Plomyk1/Comet-Dryer/README.md

# Comet Dryer


Comet Dryer hero image

Comet Dryer is a 3D printer filament dryer, with support for drying 2 spools at once!

I made this project, because I felt like trying to make something more complicated than all my previous projects. Decided on a filament dryer, since it was something I wanted to have, and the dryers i could buy seemed quite expensive for essentially just heating air inside a box

## Features:
- 50w Heater
- Fan for even distrubution of hot air
- A colorful 320x170 display
- Rotary encoder for navigating the menus
- UI fully written in C++ with the Adafruit GFX Library
- 13 Color themes
- 15 presets for drying different materials and dessicant

## CAD Model: 
Full cad assembly
Enclosure
Heater and fan bracket

The PCB and enclosure is put together with 5 M3x10 screws and heatset insters. Both the barrel jack and power switch is press fit into the enclosure. The heater and fan addembly is mounted with 2 M5x80 screws. The fan is screwed the the 3D printed bracket with 4 M4x20 screws

You can find all the STL and STEP files in the [CAD directory](/CAD)

## PCB:
Back side of the PCB
Front side of the PCB

The PCB has been designed to be manufactured by PCBWay. It may also fit the requirements of other manufacturers, but that is currently untested!
You can view the PCB wiring on KiCanvas with the button at the top of the readme

PCB power wiring diagram

Diagram showing how the PCB is connected to power to the power supply

### If you want to make this dryer yourself, have a look at the assembly instructions in the [assembly.md](assembly.md) file!

## Credits:
Libraries I used: 
- [Adafruit ST7789](https://github.com/adafruit/Adafruit-ST7735-Library) by Adafruit Industries
- [Adafruit GFX](https://github.com/adafruit/Adafruit-GFX-Library) by Adafruit Industries
- [Adafruit AHTX0](https://github.com/adafruit/Adafruit_AHTX0) by Adafruit Industries
- [RotaryEncoder](https://github.com/mathertel/RotaryEncoder) by Matthias Hertel

AI use:

I have only used AI for debugging, and minor got help with electrical issues. All code in firmware.cpp was written by me
