Plomyk1/Comet-Dryer/CAD/README.md

You can find the full assemblies in the STEPs folder. The STLs folder only includes things ment to be 3D printed

If you want to see how I made everything, you can view my CAD [here](https://cad.onshape.com/documents/a778b5edc86127cb74244df1/w/2368e3ce15f5868e0e34b6d9/e/8c6bc288f30ad08ca65c21fe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)
