Plomyk1/Comet-Dryer/BOM.csv

Item name | Qty | Total price (USD) | Link | Notes
12v 10.5A PSU | 1 | 18,84 | https://allegro.pl/produkt/zasilacz-modulowy-mean-well-12v-12-5a-150w-lrs-150-12-4e65e1d5-06b7-4d24-8f40-de88eebae00e?offerId=15477527985 | I recommend getting this over a brick (barrel jack) power supply. Model: Mean Well LRS-150-12
PCB | 1 | 14,20 | PCBWay | Price quoted from PCBWay, since that is where I had my PCB manufactured. Includes Fees, shipping and taxes
Container | 1 | "7 | 35" | https://www.ikea.com/pl/pl/p/ikea-365-pojemnik-na-zywnosc-z-pokrywka-prostokat-plastik-s79276760/
50mm Fan | 1 | 2,54 | https://pl.aliexpress.com/item/1005006020005975.html
AHT20 + BMP280 module | 1 | 2,18 | https://pl.aliexpress.com/item/1005008239843130.html | Themperature and humidity sensor. The BMP280 isn't used
12v 50w PTC Heater | 1 | 5,77 | https://pl.aliexpress.com/item/1005009279284775.html
Female barrel jacks | 1/10 | 2,32 | https://pl.aliexpress.com/item/1005012242149457.html | Only one of the 10 is used
1.9" TF 320x170 Display | 1 | 5,24 | https://pl.aliexpress.com/item/1005010094030749.html
KY040 Rotary encoder | 1 | 2,54 | https://pl.aliexpress.com/item/1005008796691020.html
IRLZ44N Mosfets | 2/10 | 3,36 | https://pl.aliexpress.com/item/1005009630861300.html | 2 of the 10 are used
KCD101-1 Power switch | 1/5 | 1,95 | https://pl.aliexpress.com/item/1005013414323454.html | 1/5 is used. Different listing from my order
RP2040-Zero | 1 | 4,99 | https://www.waveshare.com/rp2040-zero.htm?sku=20335
Step-down buck converter | 1 | 0,89 | https://pl.aliexpress.com/item/1005012741976007.html | LM2596S. 1,19USD shipping
1N4007 Diode | 1/10 | 1,39 | https://pl.aliexpress.com/item/1005012179615414.html | 1/10 is used
Heatset inserts | 5/50 | 2,54 | https://pl.aliexpress.com/item/1005006472702418.html | 5/10 are used. M3xL4xOD4.5 50Pcs option
M3x10 screws | 5/30 | 1,57 | https://www.leroymerlin.pl/produkty/sruba-walcowa-z-rowkiem-30-mm-stal-ocynk-3-x-10-mm-30-szt-standers-82582805.html | Local vendor. 5/30 screws screws in the package are used
M4x20 screws | 2/20 | 1,49 | https://www.leroymerlin.pl/produkty/sruba-plaska-srednica-20-mm-stozkowa-stal-ocynk-4-x-20-mm-20-szt-standers-82582740.html | Local vendor. 5/30 screws screws in the package are used
M5x80 screws | 2/6 | 1,57 | https://www.leroymerlin.pl/produkty/sruba-plaska-srednica-6-mm-stozkowa-stal-ocynk-5-x-80-mm-6-szt-standers-82582794.html | Local vendor. 2/6 screws screws in the package are used
~1.5mm² Wire (16AWG) | ~0.5m | 1,00 | https://www.leroymerlin.pl/produkty/przewod-elektryczny-ydyp-2-x-1-5-450-750v-aks-zielonka-41302926.html | I used some wires I already had. The lenght and price is estimated
Sunlu PETG HS | 39.17g | 0,49 | 3D printed | Does not include previous designs / failed attempts
Professional LAB ASA | 21.14g | 0,21 | 3D printed | Does not include previous designs / failed attempts
