Plomyk1/Comet-Dryer/CAD/STEPs/Fan and heater mounting assembly.step

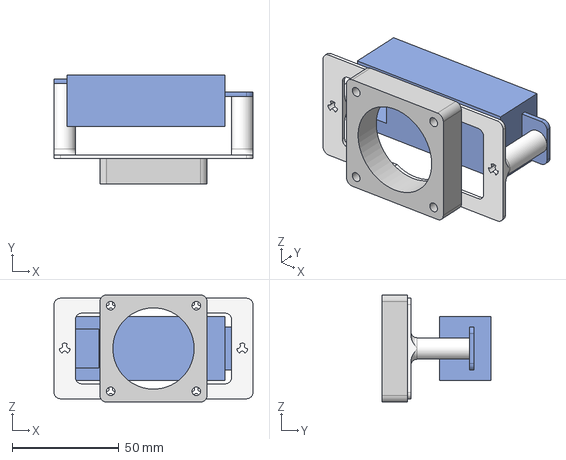
[picture p1: CAD file, 2026-10-28]
CAD/STEPs/Fan and heater mounting assembly.step
93.0 x 51.0 x 50.0 mm
