Plomyk1/Comet-Dryer/CAD/STEPs/FULL assembly.step

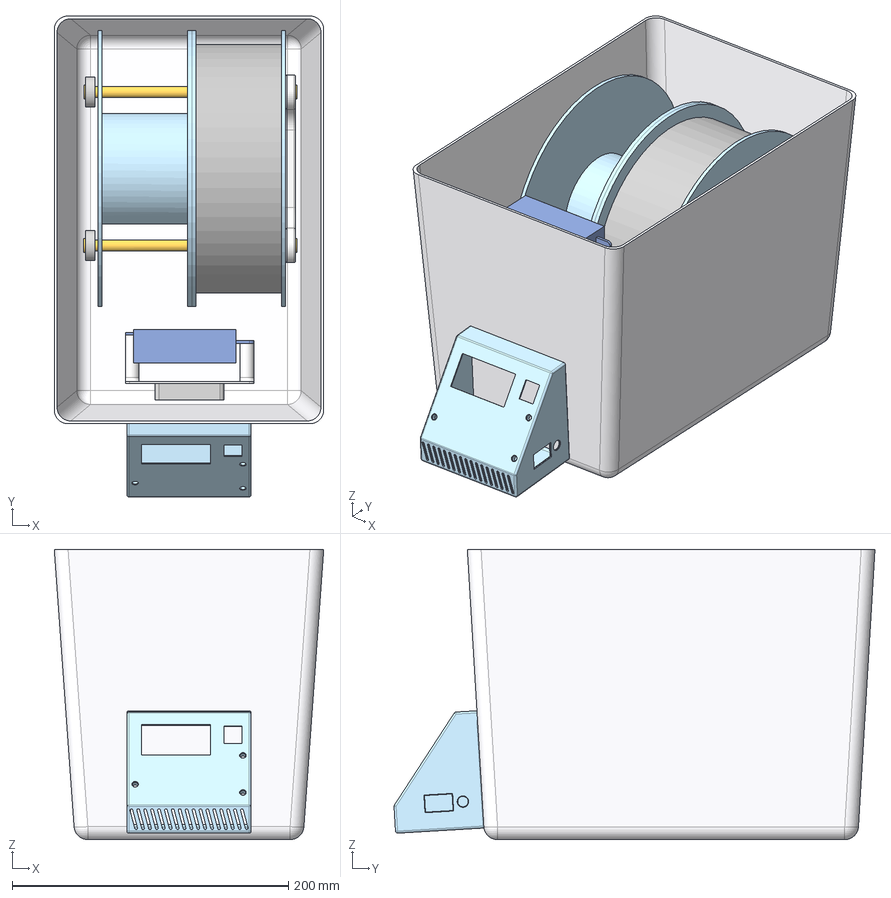
[picture p2: CAD file, 2026-10-28]
CAD/STEPs/FULL assembly.step
195.0 x 348.0 x 210.0 mm
Bearing x 4
Rod x 2
Spool x 2
End cap x 4
Container
Enclosure
Filament
Stand
Fan
Heater
Mounting bracket
