Plomyk1/Comet-Dryer/CAD/STEPs/Spool stand assembly.step

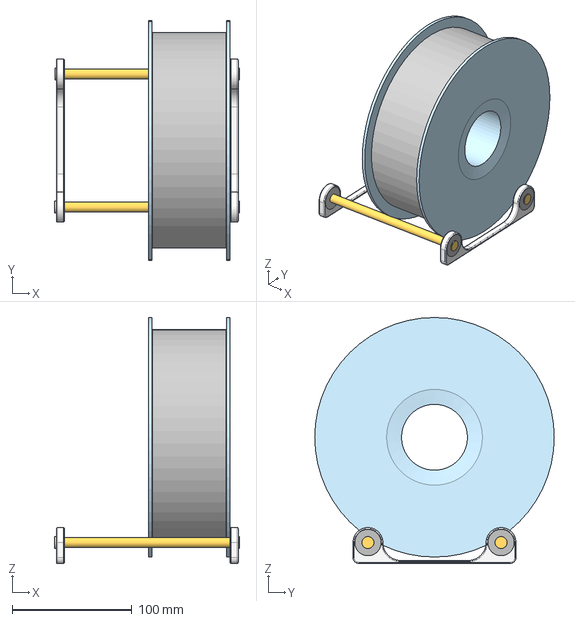
[picture p3: CAD file, 2026-10-28]
CAD/STEPs/Spool stand assembly.step
154.5 x 200.0 x 205.4 mm
