Plomyk1/Comet-Dryer/CAD/STEPs/Fan and heater mounting bracket.step

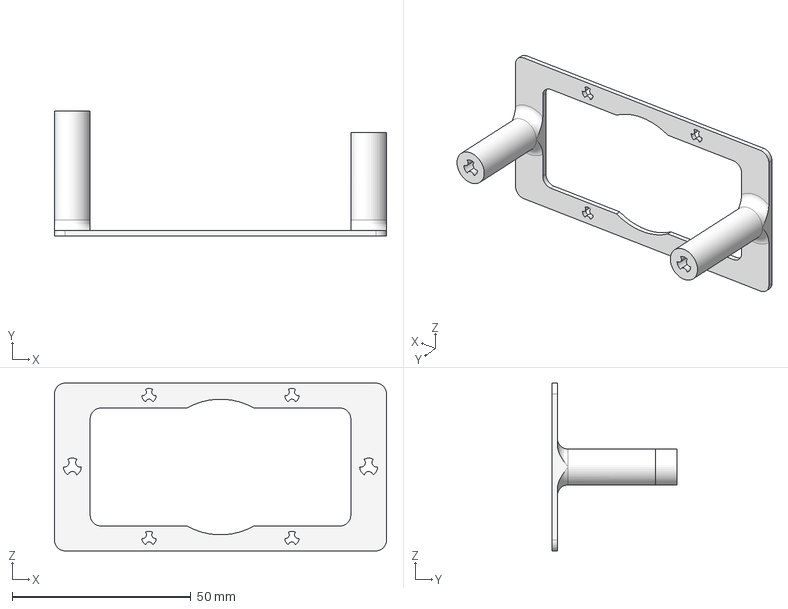
[picture p4: CAD file, 2026-10-28]
CAD/STEPs/Fan and heater mounting bracket.step
93.0 x 35.0 x 47.0 mm
