Plomyk1/Comet-Dryer/CAD/STLs/Heater and fan mounting bracket.stl

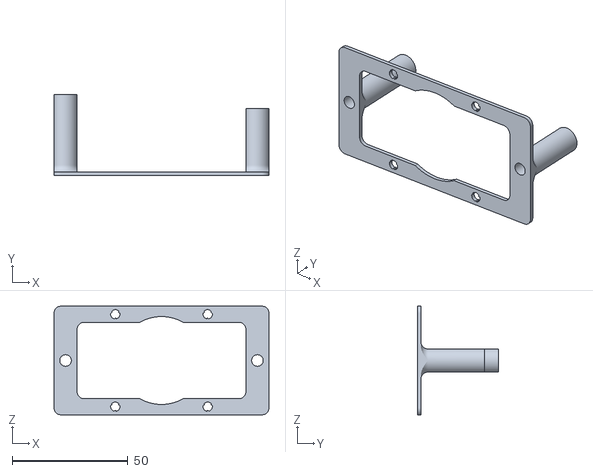
[picture p5: CAD file, 2026-10-28]
CAD/STLs/Heater and fan mounting bracket.stl
93.0 x 35.0 x 47.0
