Plomyk1/Comet-Dryer/CAD/STEPs/Spool stand.step

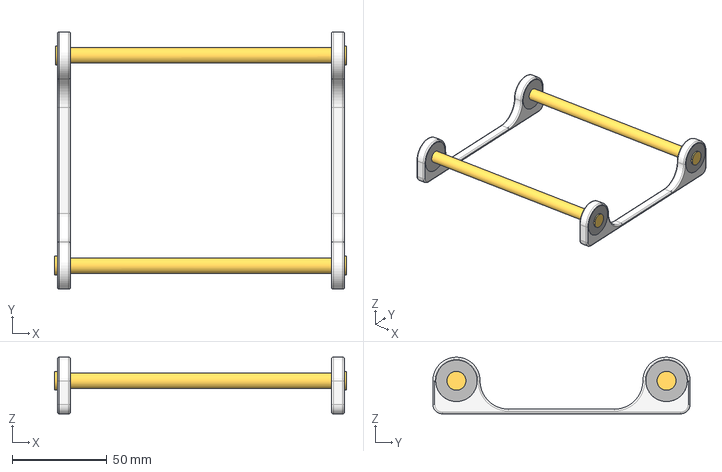
[picture p6: CAD file, 2026-10-28]
CAD/STEPs/Spool stand.step
154.5 x 136.2 x 30.0 mm
