Plomyk1/Comet-Dryer/CAD/STEPs/Enclosure v2.step

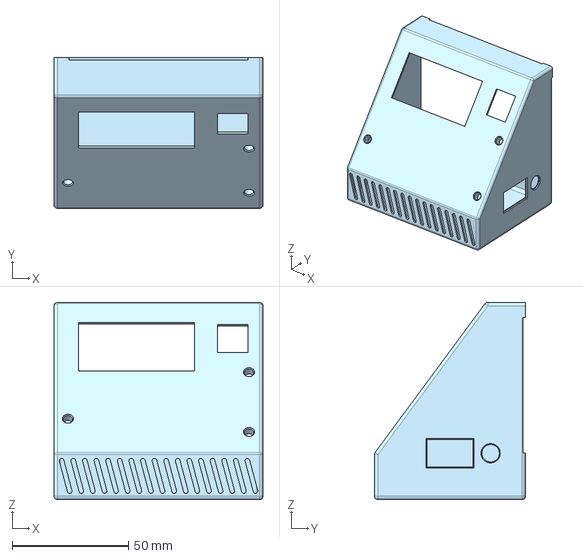
[picture p7: CAD file, 2026-10-28]
CAD/STEPs/Enclosure v2.step
90.0 x 65.0 x 85.0 mm
