Plomyk1/Comet-Dryer/(list of files, cad)

Other CAD files:
CAD/STLs/Enclosure v2.stl
CAD/STLs/Spool stand.stl
