Plomyk1/Comet-Dryer/PCB/Filament Dryer.kicad_pcb

## KiCad design PCB/Filament Dryer.kicad_pcb (2026-10-28)

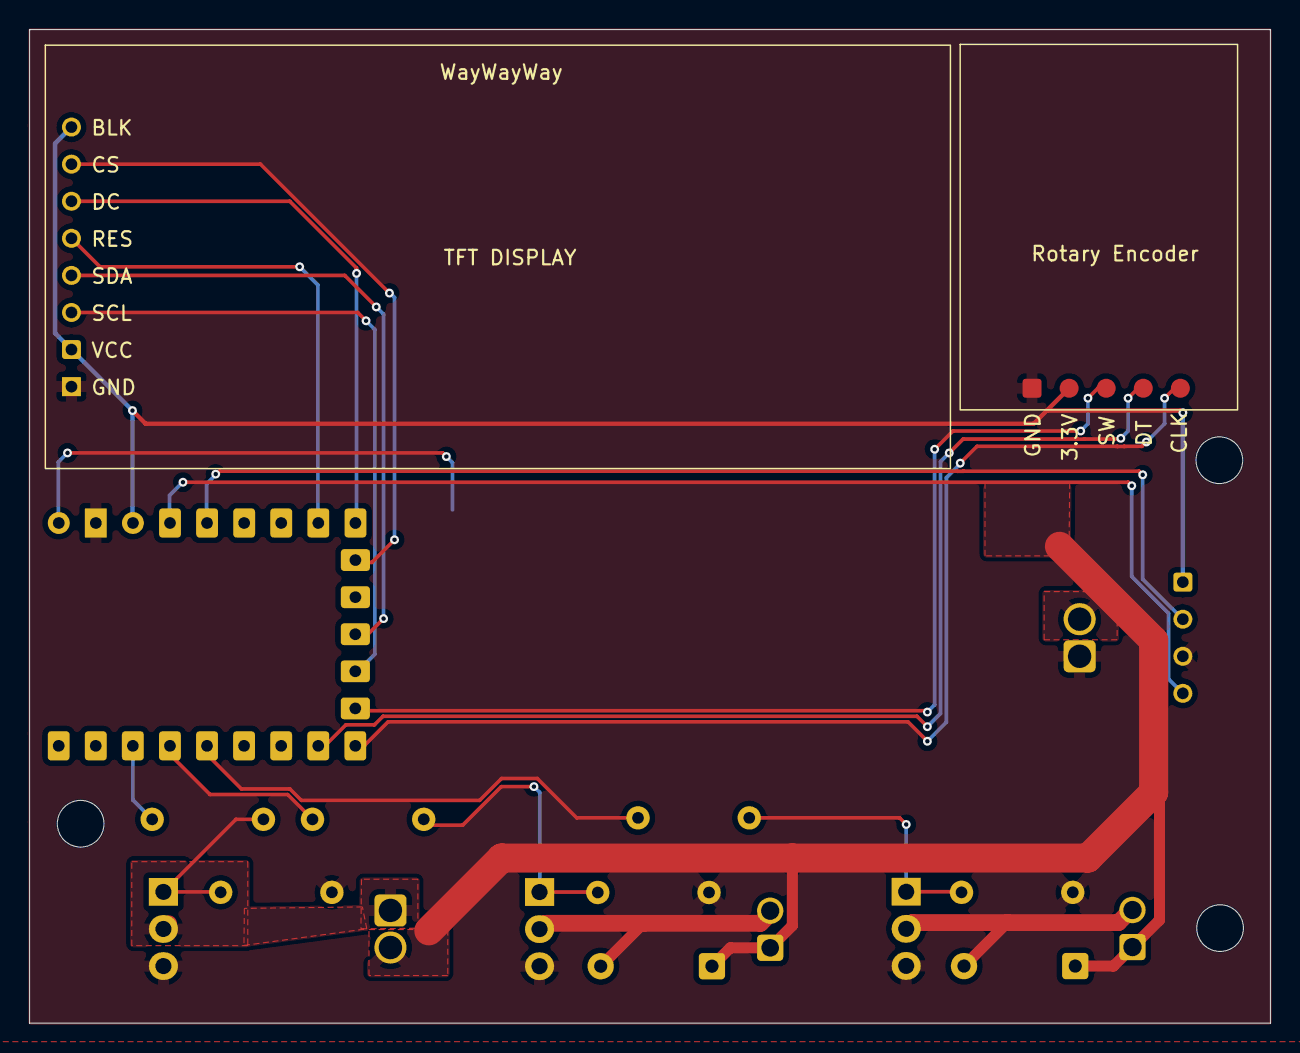
[picture p8: board Filament Dryer.kicad_pcb from above]

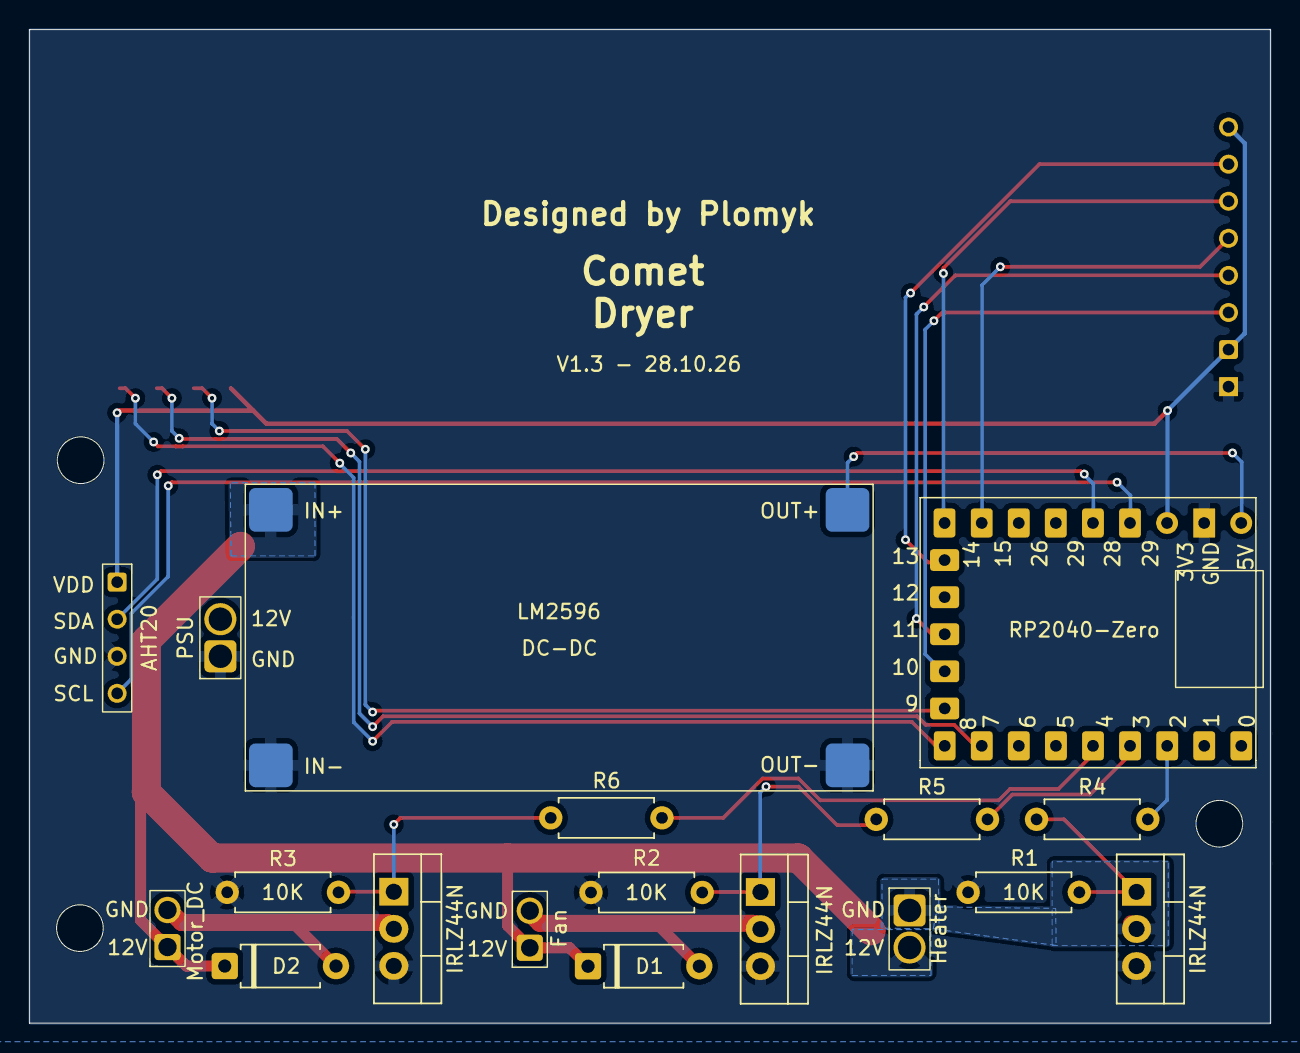
[picture p9: board Filament Dryer.kicad_pcb from below]

Board: 2 copper layers, 85.0 x 68.1 mm, 20 parts (17 on the bottom side), 23 nets.

Parts:
D1, D2: D; D_A-405_P7.62mm_Horizontal
M1: Fan; Fan footprint
M2: Motor_DC; Motor footprint
Q1, Q2, Q3: IRLZ44N; TO-220-3_Vertical
R1, R2, R3: 10K; R_Axial_DIN0207_L6.3mm_D2.5mm_P7.62mm_Horizontal
R4, R5, R6: 220; R_Axial_DIN0207_L6.3mm_D2.5mm_P7.62mm_Horizontal
U1: LM2596; LM2596 module footprint
U2: RP2040-Zero; RP2040-Zero Devboard footprint
U3: KY040; KY-040 Rotary encoder footprint
U4: 320x170 TFT; 1.9' TFT Display footprint
U5: Heater; Heater footprint
U6: PSU; PSU +12V footprint
U8: AHT20; Temperature sensor footprint

Connections:
+3.3V: U2.30 (3.3V), U3.2 (VCC), U4.2 (VCC), U4.8 (BLK), U8.1 (VDD)
+5V: U1.3 (OUT+), U2.32 (5V)
+12V: D1.1 (K), D2.1 (K), M1.1 (+), M2.1 (+), U1.1 (IN+), U5.2 (+12V), U6.2 (12V)
GND: Q1.3 (S), Q2.3 (S), Q3.3 (S), R1.2, R2.2, R3.2, U1.2 (IN-), U1.4 (OUT-), U2.31 (GND), U3.1 (GND), U4.1 (GND), U6.1 (GND), U8.3 (GND)
unnamed: D1.2 (A), M1.2 (-), Q2.2 (D)
unnamed: D2.2 (A), M2.2 (-), Q3.2 (D)
unnamed: Q1.2 (D), U5.1 (GND)
unnamed: Q1.1 (G), R1.1, R4.2
unnamed: Q2.1 (G), R2.1, R5.2
unnamed: Q3.1 (G), R3.1, R6.2
unnamed: R4.1, U2.2 (GPIO)
unnamed: R5.1, U2.3 (GPIO)
unnamed: R6.1, U2.4 (GPIO)
unnamed: U2.8 (GPIO), U3.5 (CLK)
unnamed: U2.7 (GPIO), U3.4 (DT)
unnamed: U2.9 (GPIO), U3.3 (SW)
unnamed: U2.13 (GPIO), U4.7 (CS)
unnamed: U2.14 (GPIO), U4.6 (DC)
unnamed: U2.15 (GPIO), U4.5 (RES)
unnamed: U2.10 (GPIO), U4.3 (SCL)
unnamed: U2.11 (GPIO), U4.4 (SDA)
unnamed: U2.29 (GPIO), U8.4 (SCL)
unnamed: U2.28 (GPIO), U8.2 (SDA)
