Plomyk1/Comet-Dryer/(commit log)

2026-09-19 Rewrite Color theme selection menu : Finished and fixed related bugs
    [main.cpp]
2026-09-26 Add Fan support Add Motor support Fix bugs in settings and appearance menu
    [main.cpp]
2026-09-28 Add annealing menu Fix related bugs Clean up code for shipping
    [main.cpp]
2026-10-28 Add CAD, PCB and uf2 files Fix bugs found in code Comment out motor code; no longer used Rename src to firmware Put files in structurized folders
    [Enclosure v2.step, Enclosure v2.stl, FULL assembly.step, Fan and heater mounting assembly.step, Fan and heater mounting bracket.step, Filament Dryer.kicad_pcb, Filament Dryer.kicad_sch, Heater and fan mounting bracket.stl]
2026-10-30 Add assembly instructions
    Added instructions on how to assemble the project
2026-10-30 Update link to assembly instructions
2026-10-30 Add a BOM.csv file
    Adding a Bill Of Materials file with all the items required for assembling everything together
    [BOM.csv]
2026-10-30 Add Gerbers.zip
2026-10-30 Add a README file to the CAD folder
2026-10-30 Update assembly instructions
    Reworded PSU recommendation and adjusted the location of an image not to be in the middle of text
2026-10-31 Add a wiring diagram to the readme
